ryood/Non-inv-HPA-/Non-inv HPAmp_brd.png

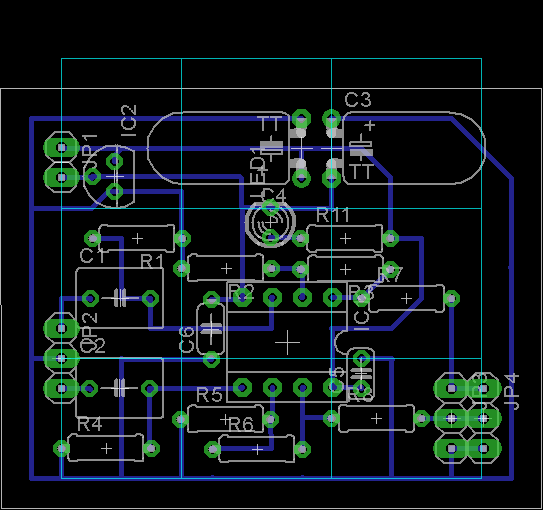
Non-inv HPAmp_brd.png
