ryood/Non-inv-HPA-/Non-inv HPAmp_sch.png

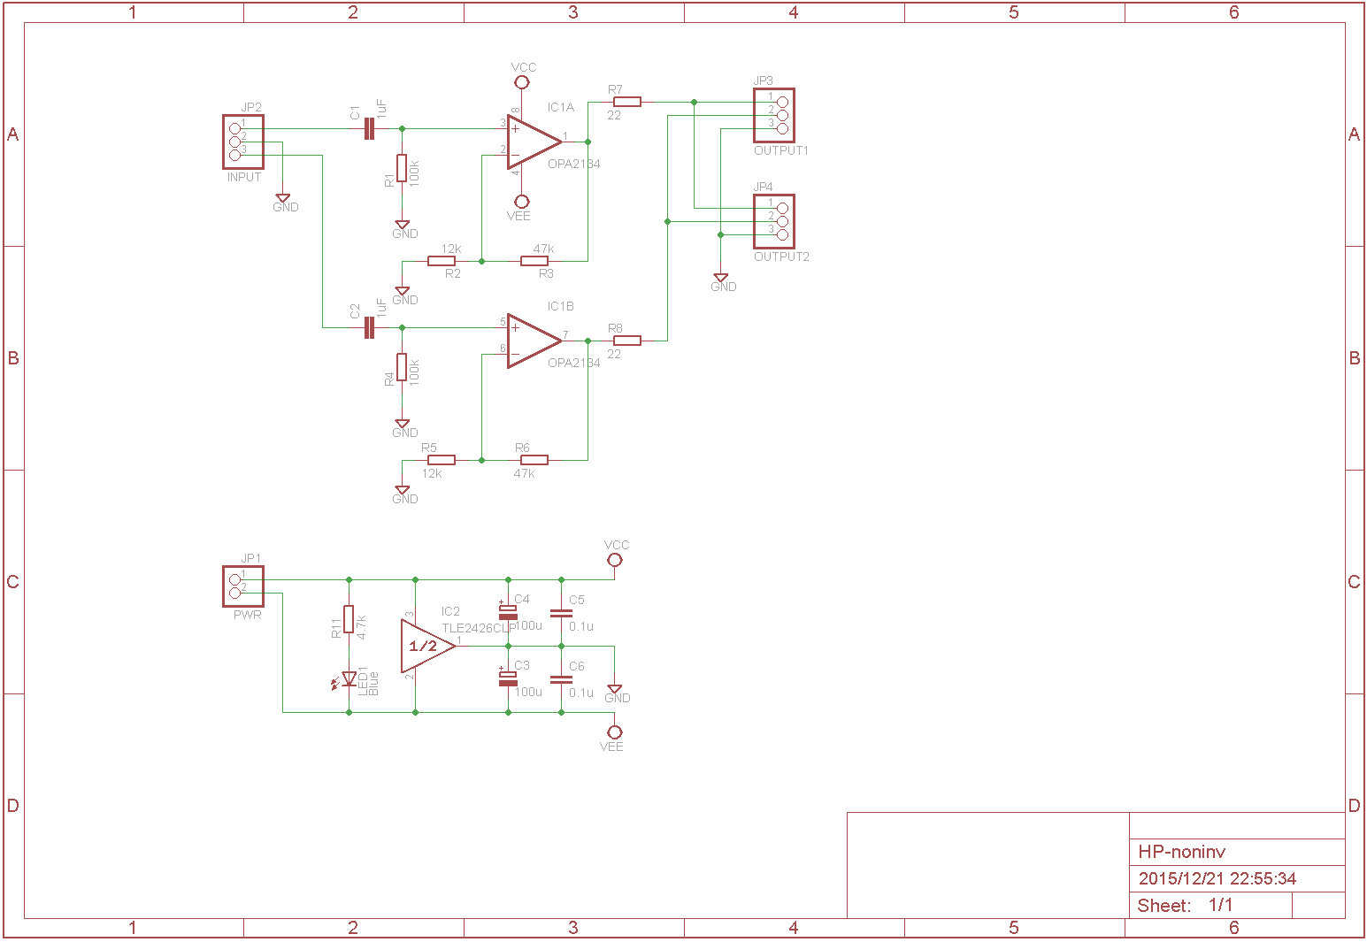
Non-inv HPAmp_sch.png
