ryood/Non-inv-HPA-/Non-inv HPAmp_ブレッドボード.png

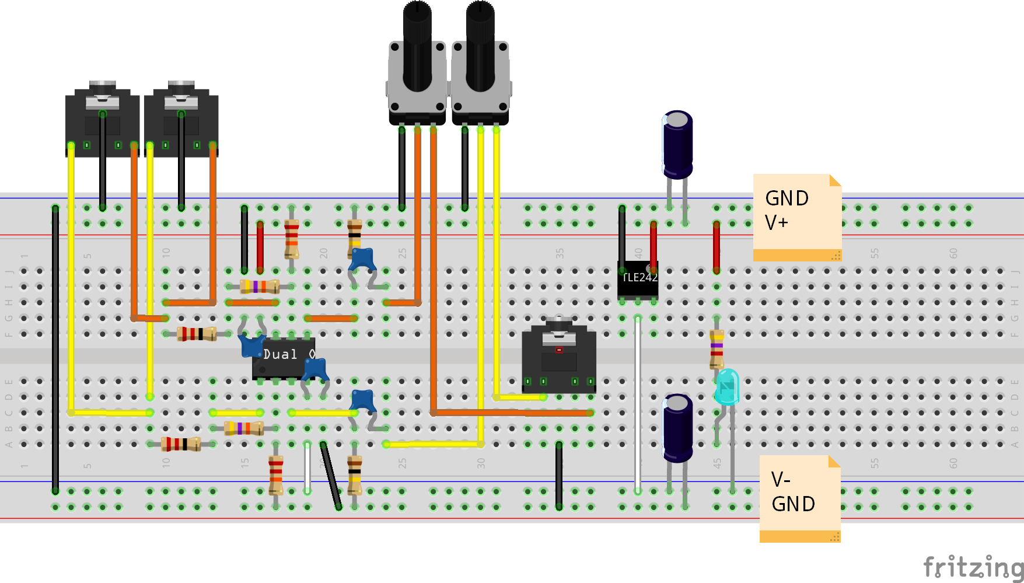
Non-inv HPAmp_ブレッドボード.png
