ryood/Non-inv-HPA-/Non-inv HPAmp_テスト表_20151221.xlsx

Sheet: Sheet1
Non-inv Headphone Amp テスト表
2015.12.21
電源なし、ICの挿入なし
項番 | Point1 | Point2 | 値 | 2015.12.21 #1
 | IC1-1 | JP3-1 | 22ohm | 21.6ohm
 | IC1-1 | JP4-1 | 22ohm | 21.6ohm
 | IC1-1 | GND | 47kohm | 47.0kohm
 | IC1-1 | IC1-2 | 59kohm | 59.0kohm
 | IC1-2 | GND | 12kohm | 11.98kohm
 | IC1-3 | GND | 100kohm | 100.0kohm
 | IC1-3 | JP2-1 | 1uF | 1024.8nF
 | IC1-4 | VCC | con | 0.07ohm
 | IC1-5 | GND | 100kohm | 100.23kohm
 | IC1-5 | JP2-3 | 1uF | 1027.3nF
 | IC1-6 | GND | 12kohm | 11.98kohm
 | IC1-6 | IC1-7 | 59kohm | 58.9kohm
 | IC1-7 | JP3-2 | 22ohm | 21.8ohm
 | IC1-7 | JP4-2 | 22ohm | 21.6ohm
 | IC1-8 | VEE | con | 0.0ohm
 | JP2-2 | GND | con | -
 | JP3-4 | GND | con | 0.0ohm
 | JP4-3 | GND | con | 0.0ohm
 | JP1-1 | R11 | con | 0.0ohm
 | JP1-1 | IC2-3 | con | 0.0ohm
 | JP1-1 | C4 | con | 0.0ohm
 | JP1-1 | C5 | con | 0.0ohm
 | JP1-2 | LED1 | con | -
 | JP1-2 | IC2-2 | con | 0.0ohm
 | JP1-2 | C3 | con | 0.0ohm
 | JP1-2 | C6 | con | 0.0ohm
 | IC2-1 | C4 | con | 0.0ohm
 | IC2-1 | C3 | con | 0.0ohm
 | IC2-1 | C5 | con | 0.0ohm
 | IC2-1 | C6 | con | 0.0ohm
電源5V、ICの挿入なし
項番 | Point1 | Point2 | 値 | 2015.12.21 #1
 | IC1-4 | GND | -2.5V | -2.54V
 | IC1-8 | GND | 2.5V | 2.55V
 | LED1 |  | lighting | ok
 |  |  | `

Sheet: Sheet2
Non-inv Headphone Amp テスト表
2015.12.22
電源なし、ICの挿入なし
項番 | Point1 | Point2 | 値 | 2015.12.22 #1
 | IC1-1 | JP3-1 | 22ohm | 21.6ohm
 | IC1-1 | JP4-1 | 22ohm | 21.6ohm
 | IC1-1 | GND | 59kohm | 59.0kohm
 | IC1-1 | IC1-2 | 47kohm | 47.0kohm
 | IC1-2 | GND | 12kohm | 11.98kohm
 | IC1-3 | GND | 100kohm | 100.0kohm
 | IC1-3 | JP2-1 | 1uF | 1024.8nF
 | IC1-4 | VEE | con | 0.0ohm
 | IC1-5 | GND | 100kohm | 100.0kohm
 | IC1-5 | JP2-3 | 1uF | 1026.2nF
 | IC1-6 | GND | 12kohm | 11.98kohm
 | IC1-6 | IC1-7 | 47kohm | 46.9kohm
 | IC1-7 | GND | 59kohm | 58.9kohm
 | IC1-7 | JP3-2 | 22ohm | 21.8ohm
 | IC1-7 | JP4-2 | 22ohm | 21.8ohm
 | IC1-8 | VCC | con | 0.0ohm
 | JP2-2 | GND | con
 | JP3-4 | GND | con
 | JP4-3 | GND | con
 | JP1-1 | R11 | con
 | JP1-1 | IC2-3 | con
 | JP1-1 | C4 | con
 | JP1-1 | C5 | con
 | JP1-2 | LED1 | con
 | JP1-2 | IC2-2 | con
 | JP1-2 | C3 | con
 | JP1-2 | C6 | con
 | IC2-1 | C4 | con
 | IC2-1 | C3 | con
 | IC2-1 | C5 | con
 | IC2-1 | C6 | con
電源5V、ICの挿入なし
項番 | Point1 | Point2 | 値 | 2015.12.21 #1
 | IC1-4 | GND | -2.5V | -2.54V
 | IC1-8 | GND | 2.5V | 2.54V
 | LED1 |  | lighting | ok
