ryood/Non-inv-HPA-/(list of files, drawings)

Other design files:
fritzing/Non-inv HPAmp.fzz
