ryood/Non-inv-HPA-/eagle/HP-noninv.brd

## EAGLE design eagle/HP-noninv.brd (2015-12-22)

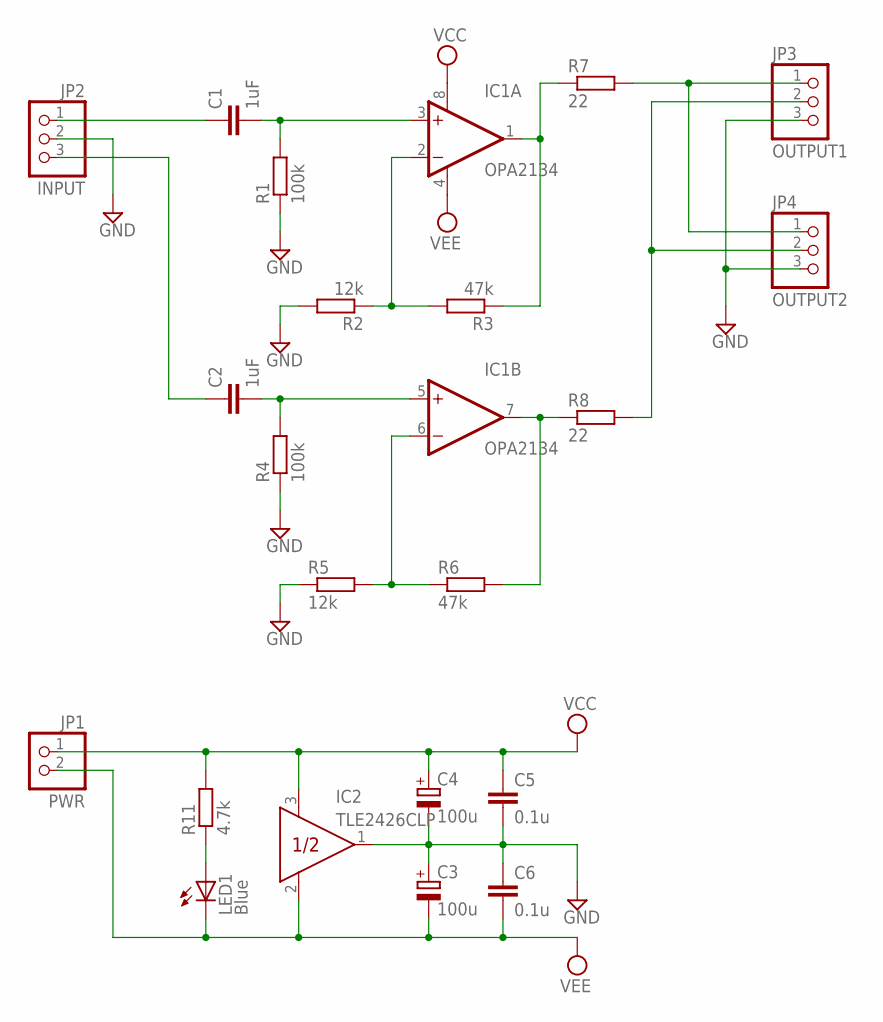
[picture p4: schematic HP-noninv.sch]

Parts:
C1, C2: 1uF; C050-050X075
C3, C4: 100u; TT5D6L
C5: 0.1u; C025-024X044
C6: 0.1u; C050-024X044
IC1: OPA2134; DIL08
IC2: TLE2426CLP; TO226AA
JP1: PWR; 1X02
JP2: INPUT; 1X03
JP3: OUTPUT1; 1X03
JP4: OUTPUT2; 1X03
LED1: Blue; LED3MM
R1, R4: 100k; 0207/7
R2, R5: 12k; 0207/7
R3, R6: 47k; 0207/7
R7, R8: 22; 0207/7
R11: 4.7k; 0207/7

Connections:
GND: C3.+, C4.-, C5.2, C6.1, IC2.1 (OUT), JP2.2, JP3.3, JP4.3, R1.1, R2.2, R4.1, R5.1
unnamed: C1.1, JP2.1
unnamed: IC1.1 (OUT), R3.1, R7.1
unnamed: C2.1, JP2.3
unnamed: IC1.7 (OUT), R6.2, R8.1
unnamed: C2.2, IC1.5 (+IN), R4.2
unnamed: C1.2, IC1.3 (+IN), R1.2
unnamed: IC1.2 (-IN), R2.1, R3.2
unnamed: JP3.1, JP4.1, R7.2
unnamed: IC1.6 (-IN), R5.2, R6.1
unnamed: JP3.2, JP4.2, R8.2
unnamed: LED1.A, R11.1
VCC: C4.+, C5.1, IC1.8 (V+), IC2.3 (IN), JP1.1, R11.2
VEE: C3.-, C6.2, IC1.4 (V-), IC2.2 (COM), JP1.2, LED1.K (C)

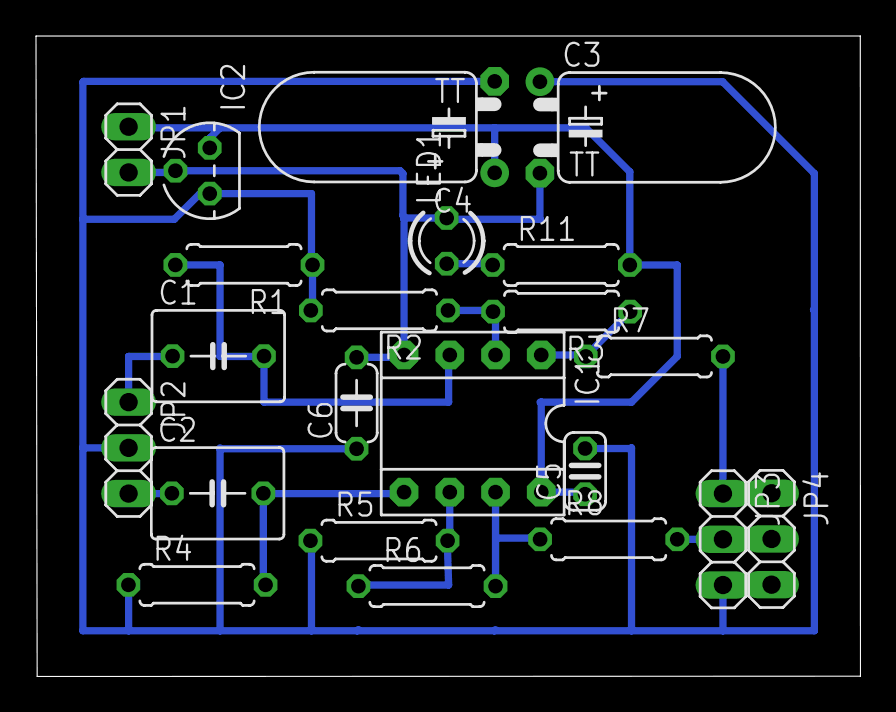
[picture p5: board HP-noninv.brd from above]

Board: 2 copper layers, 45.8 x 35.6 mm, 22 parts (0 on the bottom side), 14 nets.
