ryood/Non-inv-HPA-/(commit log)

2015-12-19 保護抵抗追加
    [HP-noninv.brd, HP-noninv.sch]
2015-12-19 ケミコンを倒して配置
    [HP-noninv.brd, HP-noninv.sch]
2015-12-21 積セラの配置を変更
    [HP-noninv.brd, HP-noninv.sch]
2015-12-22 Hardware完成
    [HP-noninv.brd, HP-noninv.sch, Non-inv HPAmp.fzz, Non-inv HPAmp_テスト表_20151221.xlsx]
